snmqwq/TenoDXController-H503/COMMERCIAL_USE.md

# 商业使用

本项目原创代码的商业使用不由根目录中的公共许可证自动授权。任何商业使用均须事先取得项目版权方或其书面指定代表的明确书面授权。

商业授权目前免费提供。免费不代表自动授权；下载、Fork、提交代码、未收到回复或其他默示行为均不构成商业授权。

商业使用包括但不限于：

- 销售包含本项目代码或固件的控制器、PCB、整机或其他产品；
- 收费代制、安装、改装、维护或技术支持；
- 众筹、预售、带利润的团购或批量制造；
- 在门店、机厅、公司、客户项目或其他经营活动中使用；
- 将本项目作为其他收费软硬件或服务的一部分。

申请可通过本项目的 GitHub Issues 联系维护者。有效授权至少应明确：

- 被授权主体；
- 获准的产品、项目或使用场景；
- 适用的版本、标签或提交；
- 授权日期和授权方。

除书面授权另有说明外，授权为免费、非独占、不可转让且不可再许可的授权，不包含项目名称、Logo 或商标权，也不免除第三方许可证义务。

个人非营利自制，以及不收取人工费或利润、仅分摊实际材料费和运费的偶发个人代制，视为非商业用途。
