snmqwq/TenoDXController-H503/ref/SCH_H503_Controller_2026-07-31.pdf

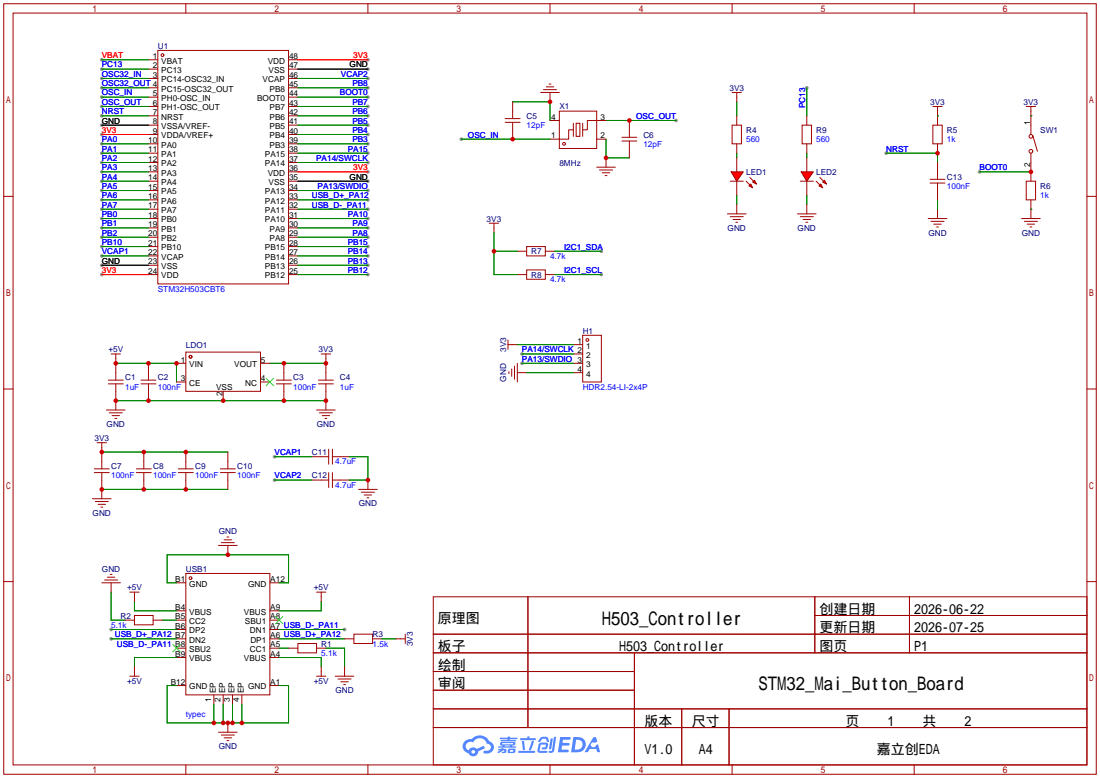
[picture p1: page 1]

原理图 | H503_Controller | 创建日期 | 2026-06-22

更新日期 | 2026-07-25

板子 | H503_Controller | 图页 | P1
绘制 | | STM32_Mai_Button_Board
审阅

V1.0 | A4 | 嘉立创EDA

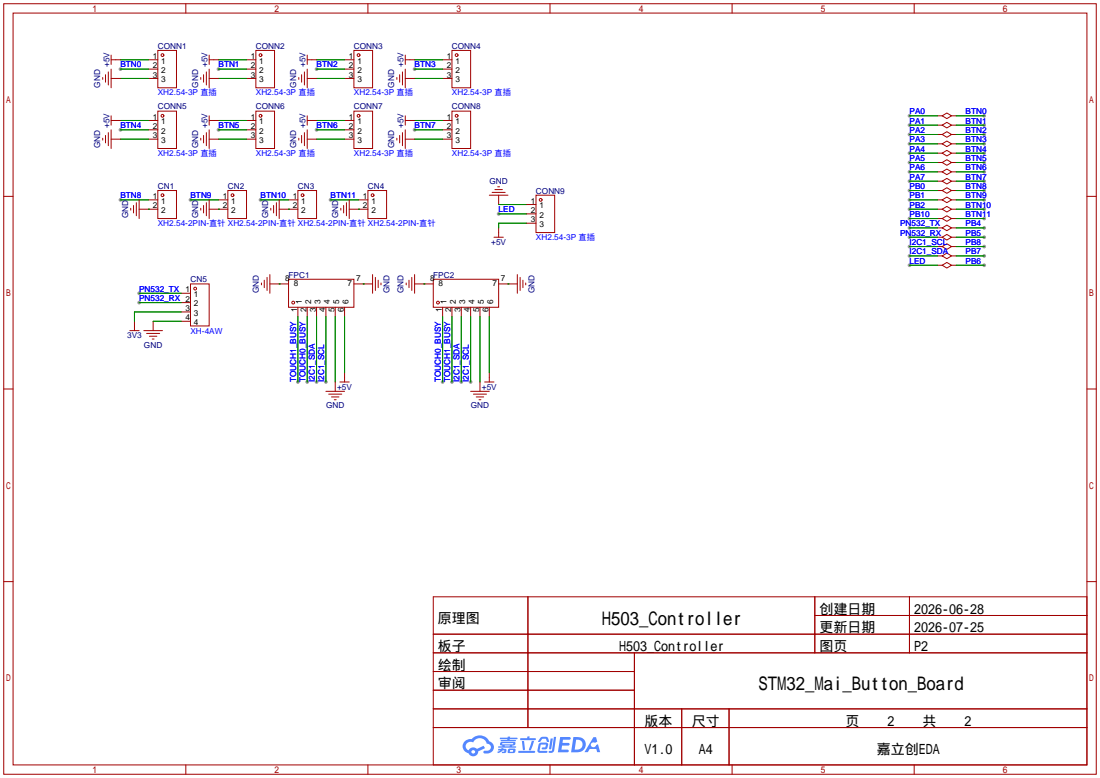
[picture p2: page 2]

原理图 | H503_Controller | 创建日期 | 2026-06-28

更新日期 | 2026-07-25

板子 | H503_Controller | 图页 | P2
绘制 | | STM32_Mai_Button_Board
审阅

V1.0 | A4 | 嘉立创EDA
