snmqwq/TenoDXController-H503/Core/Inc/main.h

#define STATUS_LED_Pin GPIO_PIN_13
#define STATUS_LED_GPIO_Port GPIOC
#define BTN0_Pin GPIO_PIN_0
#define BTN0_GPIO_Port GPIOA
#define BTN1_Pin GPIO_PIN_1
#define BTN1_GPIO_Port GPIOA
#define BTN2_Pin GPIO_PIN_2
#define BTN2_GPIO_Port GPIOA
#define BTN3_Pin GPIO_PIN_3
#define BTN3_GPIO_Port GPIOA
#define BTN4_Pin GPIO_PIN_4
#define BTN4_GPIO_Port GPIOA
#define BTN5_Pin GPIO_PIN_5
#define BTN5_GPIO_Port GPIOA
#define BTN6_Pin GPIO_PIN_6
#define BTN6_GPIO_Port GPIOA
#define BTN7_Pin GPIO_PIN_7
#define BTN7_GPIO_Port GPIOA
#define BTN8_Pin GPIO_PIN_0
#define BTN8_GPIO_Port GPIOB
#define BTN9_Pin GPIO_PIN_1
#define BTN9_GPIO_Port GPIOB
#define BTN10_Pin GPIO_PIN_2
#define BTN10_GPIO_Port GPIOB
#define BTN11_Pin GPIO_PIN_10
#define BTN11_GPIO_Port GPIOB
