snmqwq/TenoDXController-H503/(commit log)

2026-06-07 Initial import of STM32H503 controller firmware
2026-06-08 Add Mai2Touch I2C processing
2026-06-08 Restore Mai2Touch I2C processing
2026-06-09 Use separate I2C pointer and read transactions
2026-06-10 新增aime支持，测试输出psoc raw数据
2026-06-18 Add checksum to touch raw CDC frame
2026-07-29 规范命名
2026-07-29 优化psoc控制
2026-07-29 优化通讯
    增加mai2touch实现，用层切换tenodata与mai2touch
2026-07-29 迁移完成
2026-07-30 重构 Magic 配置传输并隔离 Mai2LED EEPROM
2026-07-30 重构应用模块目录并统一任务入口
2026-07-31 重构应用模块并优化构建配置
2026-07-31 扩展键盘至12键并支持1P/2P布局
2026-08-02 增加状态指示灯并补充硬件原理图
2026-08-02 延长状态灯初始化指示并完善状态恢复
2026-08-02 重构 Mai2LED 输出状态机并增强传输可靠性
2026-08-02 避免 Update 覆盖 Mai2LED 渐变
2026-08-02 统一配置工具按键显示名称
2026-08-02 增加硬件测试工具
2026-08-02 重写可移植WS2812B DMA驱动
2026-08-02 refactor: replace WS28XX with WS2812B driver
    [app.c, mai2led_app.c, mai2led_app.h, maimai_controller_H503.ioc, ws2812b.c, ws2812b.h]
2026-08-03 优化彩虹渐变为物理灯连续色相
2026-08-03 重构触摸模块并完善配置支持
2026-08-05 完善触摸配置与固件构建流程
2026-08-05 对齐 AquaMai 触摸判定参数
2026-08-05 移植 AquaMai 触摸判定算法
2026-08-06 移植最新 AquaMai 动态基线触摸算法
2026-08-06 调整 A 区触摸判定参数
2026-08-06 触摸管线支持单通道独立更新
2026-08-07 完善 Aime 寻卡与真实卡号读取
2026-08-07 合并配置存储并支持滚动保存
2026-08-07 兼容旧版 PSoC 并增加状态监控
2026-08-07 更新 CubeIDE 工具链设置
2026-08-07 忽略独立配置工具仓库
2026-08-08 Fix TinyUSB HAL include casing
    [tusb_config.h]
2026-08-10 调整键盘 HID 上报间隔
2026-08-10 完善 PSoC 固件识别与状态显示
2026-08-11 触摸算法更新
2026-08-15 切换系统时钟至 HSE 并启用 CRS CSS
2026-08-15 清理旧工具并更新项目文档
2026-08-17 升级 TinyUSB 并拆分 Debug 配置串口
2026-08-17 缩短按键扫描与消抖周期
2026-08-20 修正 HSE 时钟并调整按键扫描间隔
2026-08-20 删除 Claude 本地配置
